sconklin/rotorcontrol/docs/connector.jpg

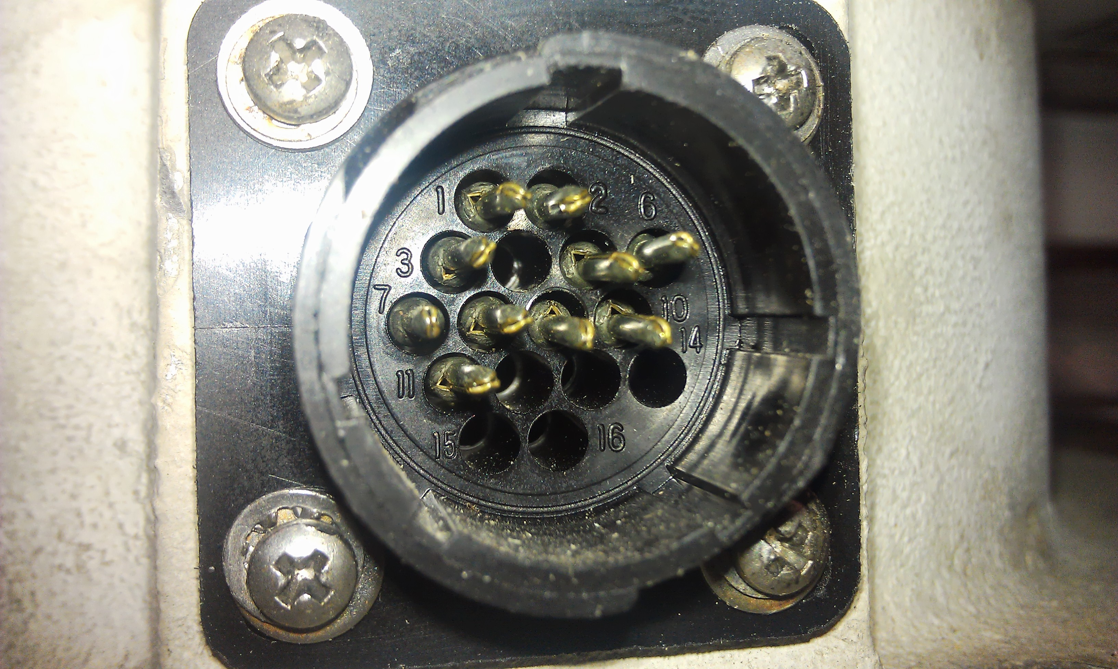
docs/connector.jpg
