sconklin/rotorcontrol/docs/hardware-0001.png

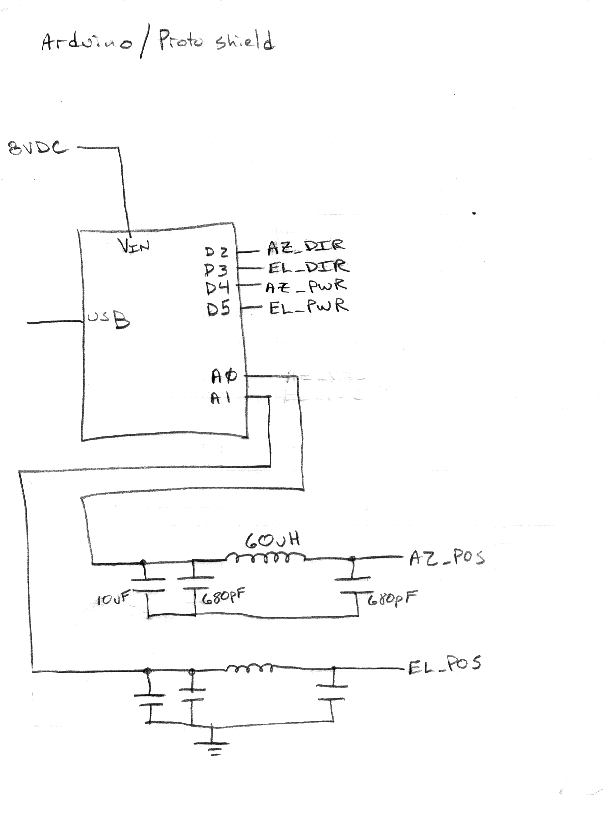
docs/hardware-0001.png
