sconklin/rotorcontrol/docs/hardware-0002.png

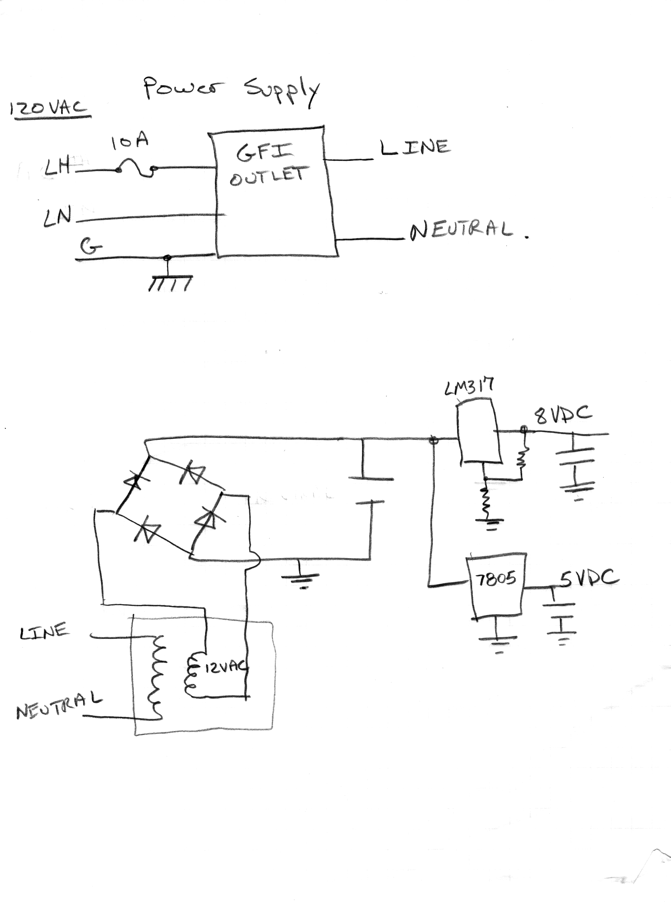
docs/hardware-0002.png
