sconklin/rotorcontrol/docs/hardware-0003.png

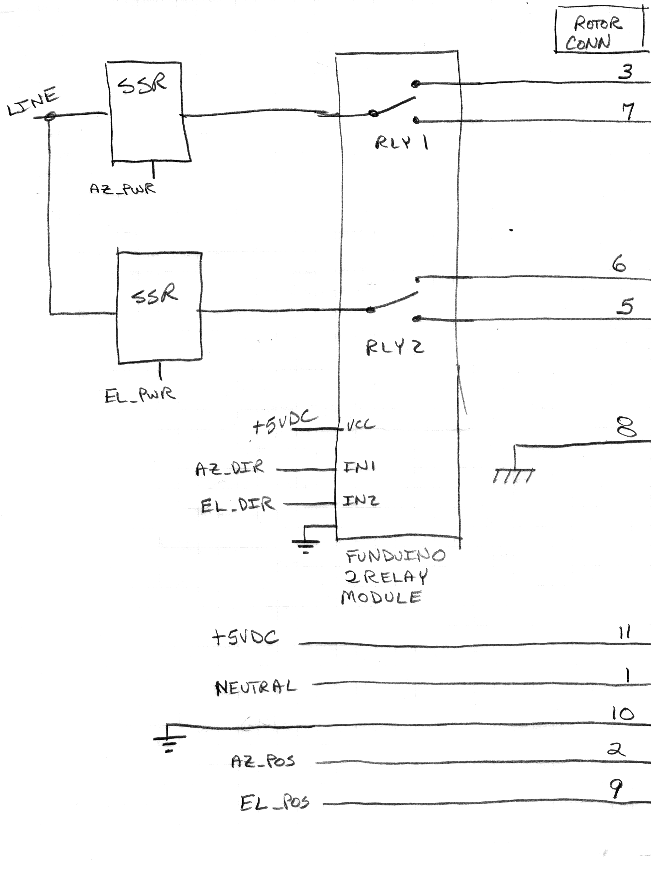
docs/hardware-0003.png
