sconklin/rotorcontrol/(commit log)

2010-12-24 break encoder functionality out of main file
2010-12-30 Encoders now work
2010-12-30 Break out encoder code to separate file
2010-12-30 added timer interrupt hander for 1000 Hz
2010-12-31 Added timer code and test to power rotor
2011-02-07 Fixed init problem
    Fixed a problem with the order of initialization of the I/O.
    Rotor now drives CW and CCW, but brake solenoid does not energize.
    The SSR is getting a control signal, so I suspect a hardware problem.
2012-10-13 Added protocol document for EASYCOMM az/el rotator
2013-09-03 New arduino sketch for azel controller
2013-09-03 changes to notes for az/el
2013-09-06 Reset clibration, add commands for Jog, Park, and analog input read
    [rotor.ino]
2013-09-07 Read the register values we wrote
    The code was reading the input pin values, instead of the values we wrote to the output registers. In some cases, this caused reading back the wrong state (i.e. we're turning right when we're actually turning left).
    [rotor.ino]
2013-09-25 Add some checks and a power saving timeout
    Added a simple check for out-of-bounds position sensor readings
    The power supply regulator for 5V was getting very warm if the
    rotator ended travel with both az and el moving in a positive direction.
    This was due to both relays for direction being energized. While
    measurements showed the regulators to be operating within limits,
    I added a timout (really a loop counter) that turns off the relays
    if no movement is under way and no movement commands have been
    sent to the controller in a while.
